shibude404/Doorway-People-Counter/Past report & slides/Milestone 1 (1).pptx

## Milestone 1

By: Eric, Sunny, Tim, Eddie, and Ketan

## Experiment 1: Regular Walking

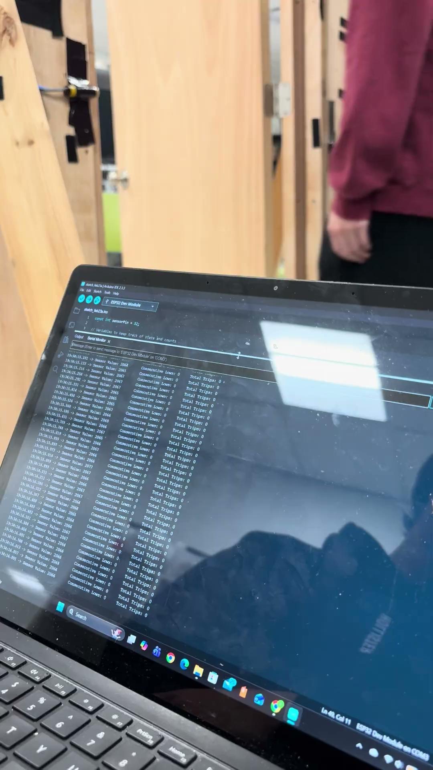
[picture p16: figure]

Sensor is able to detect a person walking through the door both ways
Software is incrementing the count by 1 only when the beam is broken, then unbroken.

## Experiment 2: Slow Walking

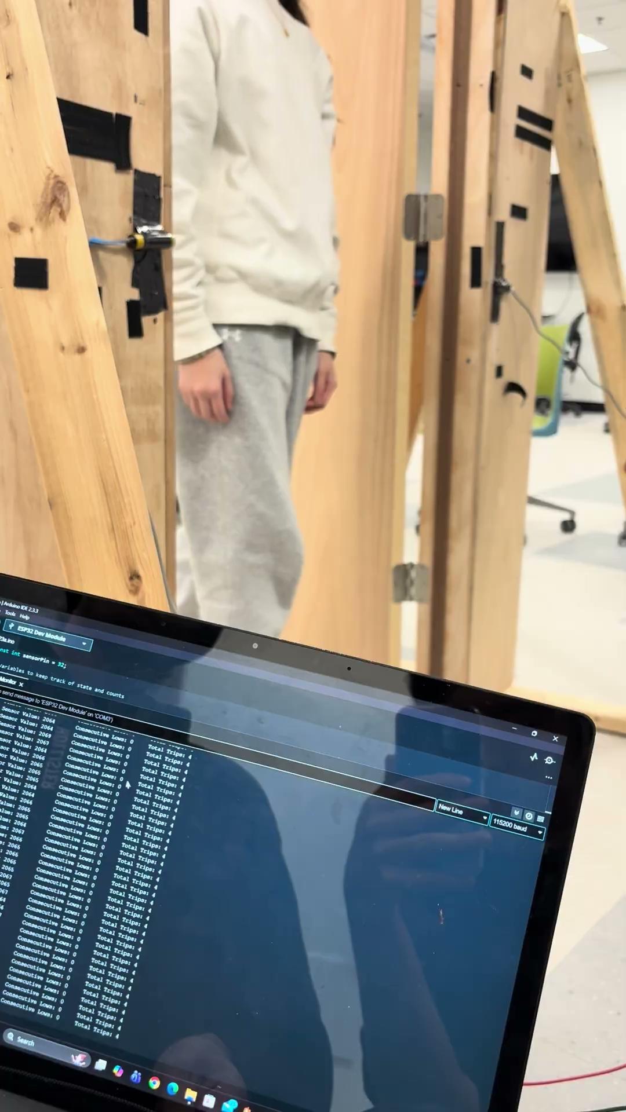
[picture p17: figure]

Sensor is able to detect a person walking through the door slowly without double counting

## Experiment 3: Fast Walking

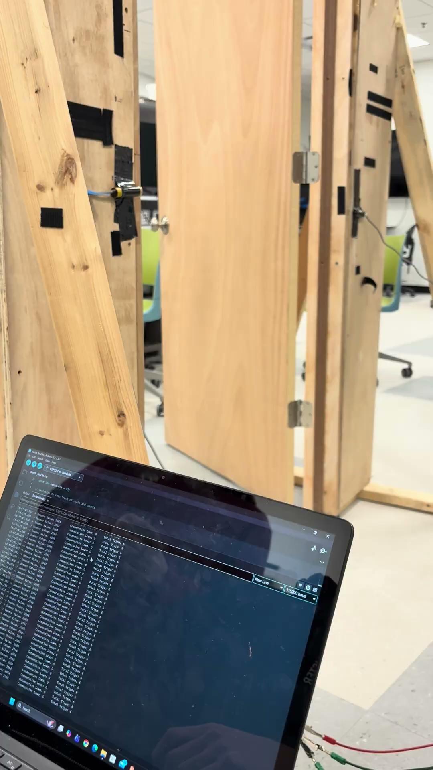
[picture p18: figure]

Sensor is able to detect a person walking through the door quickly without missing counts
Sampling time of the sensor ( 3 samples of 50 ms) is set optimally to account for fast speeds

## Experiment 4: Multiple People

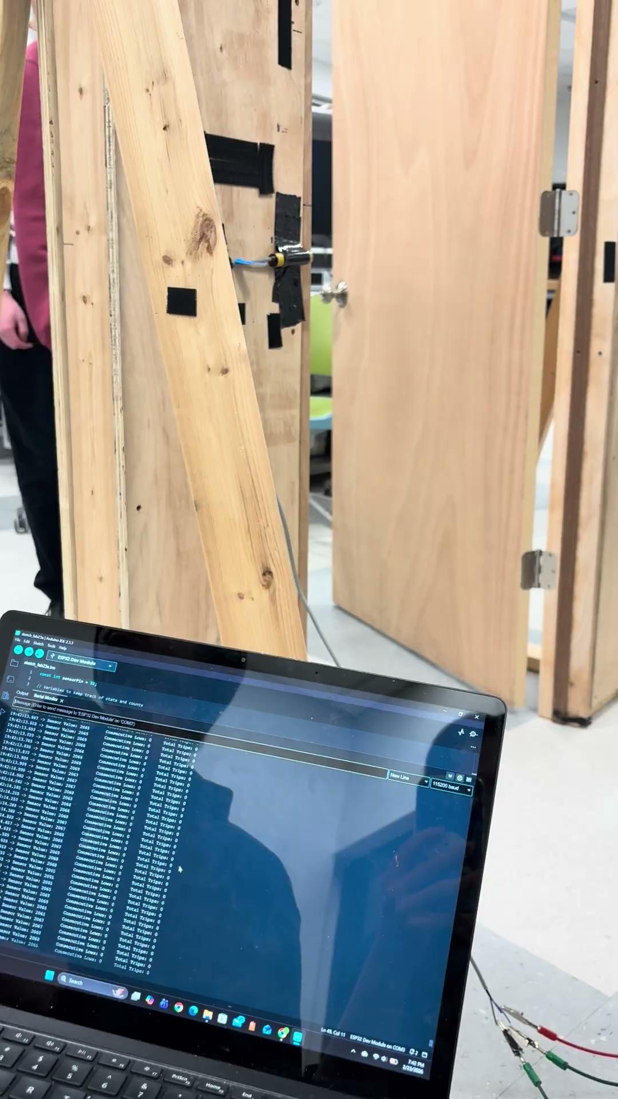
[picture p19: figure]

Sensor is able to detect a stream of people walking through with tight gaps in between

## Experiment 5: Side by Side

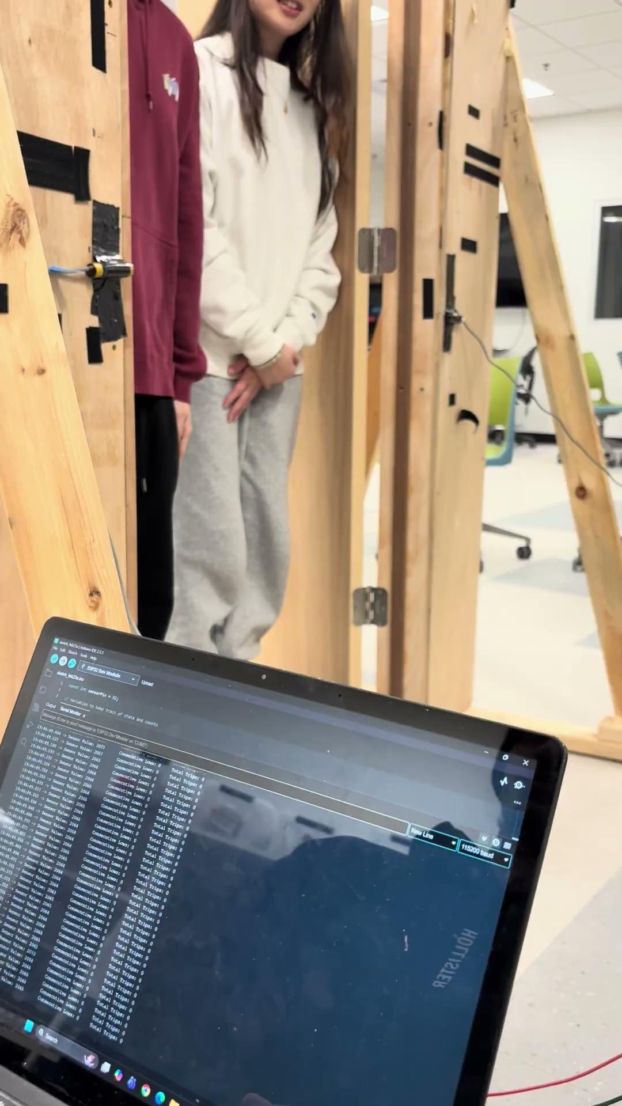
[picture p20: figure]

Sensor is unable to detect two people entering simultaneously
The beam is broken only once, hence a single count

## Experiment 6: Wheelchair

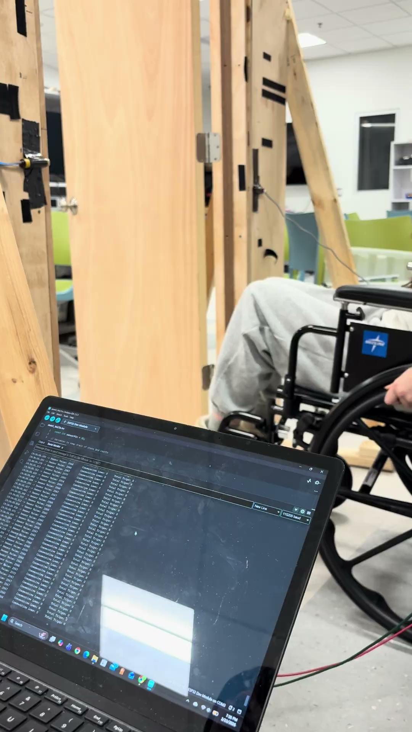
[picture p21: figure]

Sensor is able to detect a person in a wheelchair going through.
The sensor is set to a suitable height for people in wheelchairs.

## Experiment 7: Person and Wheelchair

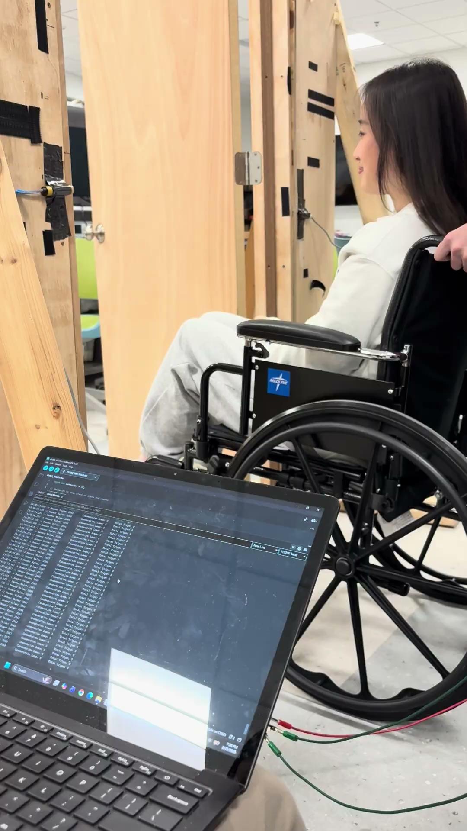
[picture p22: figure]

Sensor is able to detect a person pushing a wheelchair as two people
The sensor is set to a suitable height that sees the gap in between the wheelchair and person pushing

## Summary of Results

Passed: Regular Walking, Slow Walking, Fast Walking, Multiple People, Wheelchair, Person and Wheelchair
Failed: Side by Side (counted 1)
Next steps: Count people entering/exiting door

## Mitigating Problems/Challenges

1. Add thermal sensor to detect edge cases (i.e. 2 people side by side)
2. Use two parallel tripwires to count people entering/exiting door
3. Do early testing for communication between sensors
