shibude404/Doorway-People-Counter/Past report & slides/Milestone 2 (1).pptx

## Milestone 2

By: Eric, Sunny, Tim, Eddie, and Ketan

## Edge Case: Two people walking in at the same time

- In addition to MVS, we will use two TOF sensors mounted close to the top corners of the door
- They will be mounted at an angle of 10 degrees, to determine whether a person is entering or exiting
- When both TOFs trigger, we will know that two people are walking into and out of the room

## Edge Case 2: Person standing next to the door while another person walks out

- Person in the door will block laser sensors from registering person walking in or out
- The two TOF sensors alone will determine if a person is entering or exiting the room
- When one of the TOF sensors is triggered and the values of distance are increasing or decreasing respectively, then the person in the room is entering or exiting

## Mitigation of Errors in Readings

- Lots of testing to determine the best threshold for TOF sensors to register that a person is walking through the door
- Create algorithm based upon these tests to determine how a series of specific distance measurements correspond to entering and exiting
- TOF sensors will be set as the backup sensors in our algorithm, meaning that the laser output will be the only one used for base cases

## Mounting and Integration

Tripwire Sensors: Mounting using our 3D printed brackets, on the side of the door, that put the two sensors at a set distance from one another
Transmitter and Receiver for each of the sensors are also lined up through our mount
TOF sensors: Mounted using 3D printed brackets, providing TOF sensors an angle of 10 degrees, and securing each sensor close to the corners of the door

## Budget/Financial Status

Product | Cost
2 x E3F sensors | $18.58 * 2 = $37.16
2 TOF Sensors VL350X | $6.99
Urgenex 7.4 2200 mAh Lipo battery (x2) | $27.99
Hook and Loop Tape | $6.99
Tax + $5 per order towards the budget | $4.74 + $5.00 = $9.74
PCB + shipping | $42.14
2 x tsr 1-2450 voltage converters | $19.58
Total Cost of Materials | $150.59

## Plan for Financial Status

- We have about $50 remaining within the budget
- This can be used to purchase additional components like wires, connectors, and additional small components that will make our system easier to use
- As of right now, there are no more purchases we have to make for our final system
